osafune/peridot/fpga/peridot_lcdunit/software/lcdunit_ckplay/nd_lib/nd_egl.c.org

/**************************************************************************
	PROCYON コンソールライブラリ「nd_Lib」 (cineraria DE0 Edition)

		プリミティブレベルグラフィックドライバ

	2014/04/28	Cineraria/GREENBERYL両対応修正

 **************************************************************************/

#include "nd_egl.h"

/***** 定数・マクロ定義 ***************************************************/

#define calc_brend(_a,_b,_p)	((((_a)-(_b))*(_p) + ((_b) << 8)) >> 8)

#define nd_FONTX_REPLACE_KANJI			(0x81a0)	// 全角の対応する文字がない場合の置き換え文字(□) 

/***** 構造体定義 *********************************************************/

typedef struct {			/* FONTX形式アスキーフォント */
    char fontid[6];				// "FONTX2"という文字列が入る 
    char name[8];				// フォント名(8文字) 
    nd_u8 width;				// フォントの横幅 
    nd_u8 height;				// フォントの高さ 
    nd_u8 codetype;				// アスキーフォントは0 
} __attribute__ ((packed)) nd_FONTX_ASCII_header;

typedef struct {			/* FONTX形式漢字フォント */
    char fontid[6];				// "FONTX2"という文字列が入る 
    char name[8];				// フォント名(8文字) 
    nd_u8 width;				// フォントの横幅 
    nd_u8 height;				// フォントの高さ 
    nd_u8 codetype;				// 漢字フォントは1 
    nd_u8 tnum;					// 文字コードテーブルのエントリ数 
    struct {
		nd_u16 begin;			// 領域の始まりの文字コード 
		nd_u16 end;				// 領域の終わりの文字コード 
    } codetable[];
} __attribute__ ((packed)) nd_FONTX_KANJI_header;

/**************************************************************************
	VGAコントローラ制御
 **************************************************************************/
volatile nd_u32 nd_GsVgaVsyncCount;
volatile nd_u32 nd_GsVgaVsyncFlag;

void nd_GsVgaVsync_isr(void)
{
	nd_u32 status;

#if defined(VGA_BASE)
	status = IORD(np_VGAIO, 0);
	status &= vga_vsyncirq_clear;
	IOWR(np_VGAIO, 0, status);

#elif defined(LCDC_BASE)
	status = IORD(np_LCDCIO, 0);
	status &= lcdc_vsyncirq_clear;
	IOWR(np_LCDCIO, 0, status);

#endif

	if (nd_GsVgaVsyncCount) nd_GsVgaVsyncCount--;
	nd_GsVgaVsyncFlag = 1;
}

void nd_GsVgaVsync_isrenable(void)
{
	nd_u32 status;

#if defined(VGA_BASE)
	status = IORD(np_VGAIO, 0);
	status &= vga_vsyncirq_clear;
	status |= vga_vsyncirq_enable;
	IOWR(np_VGAIO, 0, status);

#elif defined(LCDC_BASE)
	status = IORD(np_LCDCIO, 0);
	status &= lcdc_vsyncirq_clear;
	status |= lcdc_vsyncirq_enable;
	IOWR(np_LCDCIO, 0, status);
#endif
}

void nd_GsVgaVsync_isrdisable(void)
{
	nd_u32 status;

#if defined(VGA_BASE)
	status = IORD(np_VGAIO, 0);
	status &= ~vga_vsyncirq_enable;
	IOWR(np_VGAIO, 0, status);

#elif defined(LCDC_BASE)
	status = IORD(np_LCDCIO, 0);
	status &= ~lcdc_vsyncirq_enable;
	IOWR(np_LCDCIO, 0, status);

#endif
}

void nd_GsVgaScanOn(void)
{
#if defined(VGA_BASE)
	nd_u32 status;

	status = IORD(np_VGAIO, 0);
	status |= vga_scan_enable;
//	status |= (vga_scan_enable | vga_dither_enable);	// DE0のVGA出力を使う場合 
	IOWR(np_VGAIO, 0, status);

#elif defined(LCDC_BASE)
	IOWR(np_LCDCIO, 1, lcdc_scan_enable);

#endif
}

void nd_GsVgaScanOff(void)
{
#if defined(VGA_BASE)
	nd_u32 status;

	status = IORD(np_VGAIO, 0);
	status &= ~vga_scan_enable;
	IOWR(np_VGAIO, 0, status);

#elif defined(LCDC_BASE)
	IOWR(np_LCDCIO, 1, lcdc_scan_disable);

#endif
}

void nd_GsVgaSetBuffer(nd_u32 base)
{
#if defined(VGA_BASE)
	IOWR(np_VGAIO, 1, base & 0x7fffffffUL);		// アンキャッシュ領域→物理アドレス変換 

#elif defined(LCDC_BASE)
	IOWR(np_LCDCIO, 2, base & 0x7fffffffUL);	// アンキャッシュ領域→物理アドレス変換 

#endif
}

void nd_GsVgaInit(void)
{
	nd_GsVgaVsync_isrdisable();				// 既に起動中だった場合の処理 
	nd_GsVgaScanOff();

	nd_GsVgaVsyncCount = 0;
	nd_GsVgaVsyncFlag  = 0;
}

void nd_GsVgaWaitVsync(void)
{
#if defined(VGA_BASE)
	nd_u32 vsflag;

	vsflag = IORD(np_VGAIO, 0) & vga_vsyncflag_bitmask;
	while(vsflag ==(IORD(np_VGAIO, 0) & vga_vsyncflag_bitmask)) {};

#elif defined(LCDC_BASE)
	nd_u32 status;

	if ( IORD(np_LCDCIO, 0) & lcdc_vsyncirq_enable ) {	// VSYNC割り込みで動作中 
		nd_GsVgaVsyncFlag = 0;
		while( !nd_GsVgaVsyncFlag ) {}

	} else {
		status = IORD(np_LCDCIO, 0);
		status &= lcdc_vsyncirq_clear;
		IOWR(np_LCDCIO, 0, status);
		while( !(IORD(np_LCDCIO, 0) & lcdc_vsync_bitmask) ) {}
	}

#endif
}

nd_u32 nd_GsVgaVsync_getcount(void)
{
#if defined(VGA_BASE)
	if ( IORD(np_VGAIO, 0) & vga_vsyncirq_enable ) {	// VSYNC割り込みで動作中 
		return ( nd_GsVgaVsyncCount );
	} else {
		return ( IORD(np_VGAIO, 2) );
	}

#elif defined(LCDC_BASE)
	if ( IORD(np_LCDCIO, 0) & lcdc_vsyncirq_enable ) {	// VSYNC割り込みで動作中 
		return ( nd_GsVgaVsyncCount );
	} else {
		return ( IORD(np_LCDCIO, 3) );
	}

#endif
}

void nd_GsVgaVsync_setcount(nd_u32 count)
{
#if defined(VGA_BASE)
	if ( IORD(np_VGAIO, 0) & vga_vsyncirq_enable ) {	// VSYNC割り込みで動作中 
		nd_GsVgaVsyncCount = count;
	} else {
		IOWR(np_VGAIO, 2, count);
	}

#elif defined(LCDC_BASE)
	if ( IORD(np_LCDCIO, 0) & lcdc_vsyncirq_enable ) {	// VSYNC割り込みで動作中 
		nd_GsVgaVsyncCount = count;
	} else {
		IOWR(np_LCDCIO, 3, count);
	}

#endif
}

/**************************************************************************
	カレントページをセット
 **************************************************************************/
/*
  形式 
	void nd_GsEglPage(nd_u32 viewpage, nd_u32 drawpage, nd_u32 vs)

  機能
	表示ページと描画ページをセットする
		viewpage : 表示フレームバッファアドレス 
		drawpage : 描画フレームバッファアドレス 
		vs       : 切り替えモード(0:即時切り換え / !0:VSYNCを待って切り替え) 
*/

nd_u32 nd_GsEglDrawBuffer;

void nd_GsEglPage(
		nd_u32 viewpage, nd_u32 drawpage, nd_u32 vs)
{
	if (vs) nd_GsVgaWaitVsync();

	nd_GsVgaSetBuffer(viewpage);
	nd_GsEglDrawBuffer = drawpage;
}

/**************************************************************************
	カラーをセット
 **************************************************************************/
/*
  形式 
	void nd_GsEglColor(nd_u32 color, nd_u32 bg_color, nd_u32 pastel)

  機能
	アクティブカラーを設定する
		color    : 前景色 (0x0000～0xffff)
		bg_color : 背景色 (0x0000～0xffff)
		pastel   : 混合比 (0～256)
*/

static nd_u32 nd_color;
static nd_u32 nd_bgcolor;
static nd_u32 nd_pastel;

void nd_GsEglColor(
		nd_u32 color, nd_u32 bg_color, nd_u32 pastel)
{
	nd_color   = color;
	nd_bgcolor = bg_color;
	nd_pastel  = pastel;
}

/**************************************************************************
	ＶＲＡＭに点を描画
 **************************************************************************/
/*
  形式 
	void nd_GsEglPset(nd_s32 x, nd_s32 y)

  機能
	VRAMの(x,y)にcolorで指定した点を描画する
*/

void nd_GsEglPset(
		nd_s32 x, nd_s32 y)
{
	nd_u16 *p,c;
	nd_s32 r,g,b;

	if( (void *)na_VRAM_base == na_null) return;
	if(nd_pastel == 0) return;

	if((x >= window_xmin)&&(x <= window_xmax) && (y >= window_ymin)&&(y <= window_ymax)) {
		p = (nd_u16 *)( na_VRAM_base + ((draw_base + y)<<na_VRAM_linewidth) + (x<<1));
		c = nd_color;
		if (nd_pastel < 256) {
			r = get_red(*p);
			r = calc_brend(get_red(c),  r, nd_pastel);
			g = get_green(*p);
			g = calc_brend(get_green(c),g, nd_pastel);
			b = get_blue(*p);
			b = calc_brend(get_blue(c), b, nd_pastel);
			c = set_pixel(r,g,b);
		}
		*p = c;
	}
}

/**************************************************************************
	矩形塗りつぶし
 **************************************************************************/
/*
  形式 
	void nd_GsEglBoxfill(nd_s32 x1, nd_s32 y1, nd_s32 x2, nd_s32 y2)

  機能
	VRAMの(x1,y1)-(x2,y2)の矩形内を前景色で指定した色で塗りつぶす
*/

void nd_GsEglBoxfill(
		nd_s32 x1, nd_s32 y1,
		nd_s32 x2, nd_s32 y2)
{
	nd_u16 *p,c;
	nd_s32 r,g,b,x,y;

	if( (void *)na_VRAM_base == na_null) return;
	if(nd_pastel == 0) return;

	if(x1 > x2) { x=x1;  x1=x2;  x2=x; }
	if(y1 > y2) { y=y1;  y1=y2;  y2=y; }

	if(x1 < window_xmin) x1 = window_xmin;
	if(y1 < window_ymin) y1 = window_ymin;
	if(x2 > window_xmax) x2 = window_xmax;
	if(y2 > window_ymax) y2 = window_ymax;

	if(x1 <= x2 && y1 <= y2) {
		for(y=y1 ; y<=y2 ; y++) {
			p = (nd_u16 *)( na_VRAM_base + ((draw_base + y)<<na_VRAM_linewidth) + (x1<<1));
			for(x=x1 ; x<=x2 ; x++) {
				c = nd_color;
				if (nd_pastel < 256) {
					r = get_red(*p);
					r = calc_brend(get_red(c),  r, nd_pastel);
					g = get_green(*p);
					g = calc_brend(get_green(c),g, nd_pastel);
					b = get_blue(*p);
					b = calc_brend(get_blue(c), b, nd_pastel);
					c = set_pixel(r,g,b);
				}
				*p++ = c;
			}
		}
	}
}

void nd_GsEglBox(
		nd_s32 x1, nd_s32 y1,
		nd_s32 x2, nd_s32 y2)
{
	nd_GsEglLine(x1,y1, x2,y1);
	nd_GsEglLine(x1,y2, x2,y2);
	nd_GsEglLine(x2,y1+1, x2,y2-1);
	nd_GsEglLine(x1,y1+1, x1,y2-1);
}

/**************************************************************************
	ミッチェナーアルゴリズムによる高速サークル描画
 **************************************************************************/
/*
  形式 
	void nd_GsEglCircle(nd_s32 x, nd_s32 y, nd_s32 r)

  機能
	VRAMの(x,y)を中心に前景色で指定した色で半径rの円を描画する
*/

void nd_GsEglCircle(
		nd_s32 xc, nd_s32 yc,
		nd_s32 r)
{
	nd_s32 x=0,y,d;

	y = r;
	d = 3 - (r << 1);
	while(x < y) {
		nd_GsEglPset(xc+x,yc+y);
		nd_GsEglPset(xc-x,yc+y);
		nd_GsEglPset(xc+x,yc-y);
		nd_GsEglPset(xc-x,yc-y);
		nd_GsEglPset(xc+y,yc+x);
		nd_GsEglPset(xc-y,yc+x);
		nd_GsEglPset(xc+y,yc-x);
		nd_GsEglPset(xc-y,yc-x);

		if(d < 0) {
			d = d + (x << 2) + 6;
		} else {
			d = d + ((x - y)<< 2) + 10;
			y--;
		}
		x++;
	}
	if(x == y) {
		nd_GsEglPset(xc+x,yc+y);
		nd_GsEglPset(xc-x,yc+y);
		nd_GsEglPset(xc+x,yc-y);
		nd_GsEglPset(xc-x,yc-y);
	}
}

/**************************************************************************
	ブレゼンハムアルゴリズムによる高速ライン描画
 **************************************************************************/
/*
  形式 
	viod nd_GsEglLine(nd_s32 x1, nd_s32 y1, nd_s32 x2, nd_s32 y2)

  機能
	VRAMの(x1,y1)-(x2,y2)に前景色で指定した色でラインを描画する
*/

void nd_GsEglLine(
		nd_s32 x1, nd_s32 y1,
		nd_s32 x2 ,nd_s32 y2)
{
	nd_s32 x,y,dx,dy,c1,c2,d,i;

	if((x2 - x1 + y2 - y1) <= 0) {
		x  = x2;  y  = y2;
		x2 = x1;  y2 = y1;
		x1 = x;   y1 = y;
	}

	nd_GsEglPset(x1,y1);

	dx = x2 - x1;  if(dx < 0) dx = -dx;
	dy = y2 - y1;  if(dy < 0) dy = -dy;

	if(dx > dy) {
		c2 = dy << 1;
		d  = c2 - dx;
		c1 = d - dx;
		if(y1 < y2) i = 1; else i = -1;

		y = y1;
		for(x=x1+1 ; x<=x2 ; x++) {
			if(d > 0) {
				d += c1;
				y += i;
			} else {
				d += c2;
			}
			nd_GsEglPset(x,y);
		}
	} else {
		c2 = dx << 1;
		d  = c2 - dy;
		c1 = d - dy;
		if(x1 < x2) i = 1; else i = -1;

		x = x1;
		for(y=y1+1 ; y<=y2 ; y++) {
			if(d > 0) {
				d += c1;
				x += i;
			} else {
				d += c2;
			}
			nd_GsEglPset(x,y);
		}
	}
}

/**************************************************************************
	FONTX形式フォント描画ライブラリ
 **************************************************************************/

static nd_u8 *pFONTX_kanji_top;		// カレントの漢字フォント 
static nd_u8 *pFONTX_ascii_top;		// カレントのアスキー文字フォント 

// SJIS文字コードからビットマップのオフセットを計算 
// 該当ビットマップが無い場合、na_nullを返す 
static nd_u8 *nd_GsEglFontx_putkanji(nd_s32 kcode,nd_FONTX_KANJI_header *pFont)
{
	nd_s32 i,csize,cb,ce;
	nd_u8 *pKanji;

	csize  = (((nd_s32)pFont->width + 7) >> 3) * (nd_s32)pFont->height;
	pKanji = (nd_u8 *)((nd_u32)pFont + ((nd_s32)pFont->tnum << 2) + 18);

	for(i=0 ; i<pFont->tnum ; i++) {
		cb = pFont->codetable[i].begin;
		ce = pFont->codetable[i].end;
		if (cb <= kcode && kcode <= ce) {
			pKanji += (kcode - cb) * csize;
			i = -1;
			break;

		} else {
			pKanji += (ce - cb + 1) * csize;

		}
	}
	if (i >= 0) pKanji = na_null;

	return pKanji;
}

// ASCII文字コードからビットマップのオフセットを計算 
static nd_u8 *nd_GsEglFontx_ascii(nd_s32 acode,nd_FONTX_ASCII_header *pFont)
{
	nd_s32 csize;
	nd_u8 *pAscii;

	csize  = (((nd_s32)pFont->width + 7) >> 3) * (nd_s32)pFont->height;
	pAscii = (nd_u8 *)((nd_u32)pFont + 17 + (acode * csize));

	return pAscii;
}

// １文字描画 
//  0x0000～0x00ffの範囲はACSII(半角)、0x8000～はKANJI(全角)で描画する 
//  返値として、フォントの横幅を返す 
nd_s32 nd_GsEglPutcharFont(
		nd_s32 x,nd_s32 y,
		nd_u16 c)
{
	nd_FONTX_KANJI_header *pFK;
	nd_FONTX_ASCII_header *pFA;

	nd_s32 i,j,w,h;
	nd_u8 *p,cbit = 0;

	if (c <= 0xff) {		// 半角 
		pFA = (nd_FONTX_ASCII_header *)pFONTX_ascii_top;
		if (pFA == na_null) return 0;

		p = nd_GsEglFontx_ascii(c, pFA);
		w = pFA->width;
		h = pFA->height;

	} else {				// 全角 
		pFK = (nd_FONTX_KANJI_header *)pFONTX_kanji_top;
		if (pFK == na_null) return 0;

		p = nd_GsEglFontx_putkanji(c, pFK);
		if (p == na_null) p = nd_GsEglFontx_putkanji(nd_FONTX_REPLACE_KANJI, pFK);
		w = pFK->width;
		h = pFK->height;

	}

	for(j=0 ; j<h ; j++) {
		for(i=0 ; i<w ; i++,cbit<<=1) {
			if ( !(i & 7) ) cbit = *p++;

			if ( cbit & 0x80 ) {
				nd_GsEglPset(x+i,y+j);
//				nd_GsEglPset(x+i,y+(j<<1));
//				nd_GsEglPset(x+i,y+(j<<1)+1);
			}
		}
	}

	return w;
}

void nd_GsEglPutstrFont(		// 文字列描画 
		nd_s32 x,nd_s32 y,
		char *pStr)
{
	nd_u8 *p = (nd_u8 *)pStr;
	nd_u16 c;

	while(*p != '\0') {
		c = *p++;
		if ((0x81 <= c && c <= 0x9f)||(0xe0 <= c && c <= 0xff)) {
			c = (c << 8) | *p++;
		}

		x += nd_GsEglPutcharFont(x, y, c);
		if (x > window_xmax) break;
	}

}

void nd_GsEglSetFont(			// カレント文字フォントをセット 
		void *pAscii,
		void *pKanji)
{
	pFONTX_ascii_top = (nd_u8 *)pAscii;
	pFONTX_kanji_top = (nd_u8 *)pKanji;
}

/**************************************************************************
	８ドットフォント描画ライブラリ
 **************************************************************************/
/*
  形式 
	void nd_GsEglPutchar(nd_s32 x, nd_s32 y, char *pStr)

  機能
	VRAMの(x,y)から前景色で指定した色とフォントでASCII文字列を描画する。
	８ドットフォントはカレントフォントをに指定しておく
*/
extern const nd_u8 nd_GsEglRomFont[];					// フォント定義 

//static nd_u8 *pFONT8_ascii_top = &nd_GsEglRomFont[0];	// カレントの8ドット文字フォント 
#define pFONT8_ascii_top		nd_GsEglRomFont

void nd_GsEglPutchar(			// １文字描画 
		nd_s32 x,nd_s32 y,
		char s)
{
	nd_s32 i,j,c;

	for(j=0 ; j<8 ; j++) {
		c = *(pFONT8_ascii_top +((s & 0x7f)<< 3)+ j);
		for(i=0 ; i<8 ; i++,c<<=1) {
			if((c & 0x80) != 0) nd_GsEglPset(x+i,y+j);
		}
	}
}

void nd_GsEglPutstr(			// 文字列描画 
		nd_s32 x,nd_s32 y,
		char *pStr)
{
	while(*pStr != '\0') {
		nd_GsEglPutchar(x, y, *pStr);
		x += 8;
		pStr++;
	}

}

void nd_GsEglPutdec(			// 10進数描画 
		nd_s32 x,nd_s32 y,
		nd_s32 c)
{
	char numstr[14];
	nd_s32 i,num,rem;

	if(c < 0) num = -c; else num = c;
	numstr[12] = '0';
	numstr[13] = '\0';

	i = 12;
	while(num > 0) {
		rem = num % 10;
		num /= 10;
		numstr[i--] = (char)(rem | '0');
	}
	if(c < 0) numstr[i] = '-'; else if(i < 12) i++;

	nd_GsEglPutstr(x,y, &numstr[i]);
}

void nd_GsEglPuthex2(			// 8bitバイナリ描画 
		nd_s32 x, nd_s32 y,
		nd_u32 c)
{
	nd_GsEglPutchar(x, y, (char)((c >> 4)&0x0f));
	nd_GsEglPutchar(x+8, y, (char)(c & 0x0f));
}

void nd_GsEglPuthex8(			// 32bitバイナリ描画 
		nd_s32 x,nd_s32 y,
		nd_u32 c)
{
	nd_s32 i;

	for(i=7 ; i>=0 ; i--,c>>=4) {
		nd_GsEglPutchar(x+(i<<3), y, (char)(c & 0x0f));
	}
}

/**************************************************************************
	標準８ドットフォントパターン
 **************************************************************************/

const nd_u8 nd_GsEglRomFont[] = {
	0x1C,0x26,0x63,0x63,0x63,0x32,0x1C,0x00,
	0x0C,0x1C,0x0C,0x0C,0x0C,0x0C,0x3F,0x00,
	0x3E,0x63,0x07,0x1E,0x3C,0x70,0x7F,0x00,
	0x3F,0x06,0x0C,0x1E,0x03,0x63,0x3E,0x00,
	0x0E,0x1E,0x36,0x66,0x7F,0x06,0x06,0x00,
	0x7E,0x60,0x7E,0x03,0x03,0x63,0x3E,0x00,
	0x1E,0x30,0x60,0x7E,0x63,0x63,0x3E,0x00,
	0x7F,0x03,0x06,0x0C,0x18,0x18,0x18,0x00,
	0x3C,0x62,0x72,0x3C,0x4F,0x43,0x3E,0x00,
	0x3E,0x63,0x63,0x3F,0x03,0x06,0x3C,0x00,
	0x1C,0x36,0x63,0x63,0x7F,0x63,0x63,0x00,
	0x7E,0x61,0x61,0x7E,0x61,0x61,0x7E,0x00,
	0x1E,0x33,0x60,0x60,0x60,0x33,0x1E,0x00,
	0x7C,0x66,0x63,0x63,0x63,0x66,0x7C,0x00,
	0x7F,0x60,0x60,0x7E,0x60,0x60,0x7F,0x00,
	0x7F,0x60,0x60,0x7E,0x60,0x60,0x60,0x00,
	0x00,0x00,0x00,0x00,0x00,0x00,0x00,0x00,
	0x00,0x00,0x00,0x00,0x00,0x00,0x00,0x00,
	0x00,0x00,0x00,0x00,0x00,0x00,0x00,0x00,
	0x00,0x00,0x00,0x00,0x00,0x00,0x00,0x00,
	0x00,0x00,0x00,0x00,0x00,0x00,0x00,0x00,
	0x00,0x00,0x00,0x00,0x00,0x00,0x00,0x00,
	0x00,0x00,0x00,0x00,0x00,0x00,0x00,0x00,
	0x00,0x00,0x00,0x00,0x00,0x00,0x00,0x00,
	0x00,0x00,0x00,0x00,0x00,0x00,0x00,0x00,
	0x00,0x00,0x00,0x00,0x00,0x00,0x00,0x00,
	0x00,0x00,0x00,0x00,0x00,0x00,0x00,0x00,
	0x00,0x00,0x00,0x00,0x00,0x00,0x00,0x00,
	0x00,0x00,0x00,0x00,0x00,0x00,0x00,0x00,
	0x00,0x00,0x00,0x00,0x00,0x00,0x00,0x00,
	0x00,0x00,0x00,0x00,0x00,0x00,0x00,0x00,
	0x00,0x00,0x00,0x00,0x00,0x00,0x00,0x00,
	0x00,0x00,0x00,0x00,0x00,0x00,0x00,0x00,
	0x1C,0x1C,0x1C,0x18,0x18,0x00,0x18,0x00,
	0x36,0x36,0x24,0x00,0x00,0x00,0x00,0x00,
	0x13,0x33,0x7E,0x36,0x37,0x7E,0x24,0x00,
	0x3C,0x6E,0x68,0x3E,0x0B,0x6B,0x3E,0x00,
	0x21,0x52,0x24,0x08,0x12,0x25,0x42,0x00,
	0x18,0x24,0x34,0x38,0x4D,0x46,0x39,0x00,
	0x30,0x30,0x10,0x20,0x00,0x00,0x00,0x00,
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
};

/**************************************************************************/
