osafune/peridot/fpga/peridot_lcdunit/software/lcdunit_ckplay/nd_lib/nd_egl.h.org

/**************************************************************************
	PROCYON コンソールライブラリ「nd_Lib」 (cineraria DE0 Edition)

		プリミティブレベルグラフィックドライバ

	2014/04/28	Cineraria/GREENBERYL両対応修正

 **************************************************************************/
#ifndef __nd_egl_lib_
#define __nd_egl_lib_

#include <stdio.h>
#include <alt_types.h>
#include <system.h>
#include <io.h>

//#define PIXELCOLOR_RGB565
//#define PIXELCOLOR_RGB555		// MORGEN,AMETHYST,TURQUOISE,DE0
#define PIXELCOLOR_BGR555		// TOURMALINE,GREENBERYL
//#define PISELCOLOR_YUV422		// モノクロ

/***** 定数・マクロ定義 ***************************************************/

typedef int				nd_s32;				// 符号付き32bit整数 
typedef short			nd_s16;				// 符号付き16bit整数 
typedef char			nd_s8;				// 符号付き8bit整数 
typedef unsigned long	nd_u32;				// 符号無し32bit整数 
typedef unsigned short	nd_u16;				// 符号無し16bit整数 
typedef unsigned char	nd_u8;				// 符号無し8bit整数 

#ifndef na_null
#ifdef NULL
#define na_null		NULL
#else
#define na_null		((void *)0)
#endif
#endif

#define na_VRAM_base		nd_GsEglDrawBuffer
//#define na_VRAM_size		(1024*272*2)
#define na_VRAM_size		(512*96*2)
//#define na_VRAM_linewidth	(11)
#define na_VRAM_linewidth	(10)
#define na_VRAM_linesize	(1<<na_VRAM_linewidth)

#define draw_base			(0)
//#define window_xsize		(480)
#define window_xsize		(400)
#//define window_ysize		(272)
#define window_ysize		(96)
#define window_xmin			(0)
#define window_ymin			(0)
#define window_xmax			(window_xsize-1)
#define window_ymax			(window_ysize-1)

#ifdef PIXELCOLOR_RGB555
#define get_red(_x)			(((_x) & 0x7c00)>> 7)
#define get_green(_x)		(((_x) & 0x03e0)>> 2)
#define get_blue(_x)		(((_x) & 0x001f)<< 3)
#define set_pixel(_r,_g,_b)	( (((_r) & 0xf8)<<7)|(((_g) & 0xf8)<<2)|(((_b) & 0xf8)>>3) )
#endif
#ifdef PIXELCOLOR_BGR555
#define get_red(_x)			(((_x) & 0x001f)<< 3)
#define get_green(_x)		(((_x) & 0x03e0)>> 2)
#define get_blue(_x)		(((_x) & 0x7c00)>> 7)
#define set_pixel(_r,_g,_b)	( (((_r) & 0xf8)>>3)|(((_g) & 0xf8)<<2)|(((_b) & 0xf8)<<7) )
#endif
#ifdef PIXELCOLOR_RGB565
#define get_red(_x)			(((_x) & 0xf100)>> 8)
#define get_green(_x)		(((_x) & 0x07e0)>> 3)
#define get_blue(_x)		(((_x) & 0x001f)<< 3)
#define set_pixel(_r,_g,_b)	( (((_r) & 0xf8)<<8)|(((_g) & 0xfc)<<3)|(((_b) & 0xf8)>>3) )
#endif
#ifdef PISELCOLOR_YUV422
#define get_red(_x)			(0)
#define get_green(_x)		(((_x) & 0xff00)>> 8)
#define get_blue(_x)		(0)
#define set_pixel(_r,_g,_b)	( 0x80 | (((_g) & 0xff)<<8) )
#endif

#define nd_COLORBLACK		set_pixel(  0,  0,  0)
#define nd_COLORBLUE		set_pixel(  0,  0,255)
#define nd_COLORNAVY		set_pixel(  0,  0,128)
#define nd_COLORRED			set_pixel(255,  0,  0)
#define nd_COLORPURPLE		set_pixel(255,  0,255)
#define nd_COLORGREEN		set_pixel(  0,128,  0)
#define nd_COLORLIGHTGREEN	set_pixel(  0,255,  0)
#define nd_COLORSKY			set_pixel(  0,255,255)
#define nd_COLORYELLOW		set_pixel(255,255,  0)
#define nd_COLORWHITE		set_pixel(255,255,255)
#define nd_COLORGRAY		set_pixel(128,128,128)

#define nd_wait_hsync()
#define nd_wait_vsync()					nd_GsVgaWaitVsync()
#define nd_pset(_x,_y)					nd_GsEglPset((_x),(_y))
#define nd_box(_x1,_y1,_x2,_y2)			nd_GsEglBox((_x1),(_y1),(_x2),(_y2))
#define nd_boxfill(_x1,_y1,_x2,_y2)		nd_GsEglBoxfill((_x1),(_y1),(_x2),(_y2))
#define nd_circle(_x,_y,_r)				nd_GsEglCircle((_x),(_y),(_r))
#define nd_line(_x1,_y1,_x2,_y2)		nd_GsEglLine((_x1),(_y1),(_x2),(_y2))
#define nd_symbol(_x1,_y1,_s)			nd_GsEglPutstrFont((_x1),(_y1),(_s))
#define nd_color(_cc,_cb,_p)			nd_GsEglColor((_cc),(_cb),(_p))

/***** 構造体定義 *********************************************************/

#ifdef VGA_BASE
 #define np_VGAIO				(VGA_BASE)
 #define vga_vsyncirq_enable	(1<<15)
 #define vga_vsyncirq_disable	(0<<15)
 #define vga_vsync_bitmask		(1<<14)
 #define vga_vsyncirq_clear		(~(1<<14))
 #define vga_vsyncflag_bitmask	(1<<13)
 #define vga_ovrerr_bitmask		(1<<12)
 #define vga_dither_enable		(1<<1)
 #define vga_dither_disable		(0<<1)
 #define vga_scan_enable		(1<<0)
 #define vga_scan_disable		(0<<0)
#endif

#ifdef LCDC_BASE
 #define np_LCDCIO				(LCDC_BASE)
 #define lcdc_vsyncirq_enable	(1<<15)
 #define lcdc_vsyncirq_disable	(0<<15)
 #define lcdc_hsyncirq_enable	(1<<14)
 #define lcdc_hsyncirq_disable	(0<<14)
 #define lcdc_vsync_bitmask		(1<<13)
 #define lcdc_hsync_bitmask		(1<<12)
 #define lcdc_vsyncirq_clear	(~(1<<13))
 #define lcdc_hsyncirq_clear	(~(1<<12))
 #define lcdc_lineirq_bitmask	(0x003f)
 #define lcdc_vdouble_enable	(1<<2)
 #define lcdc_hdouble_enable	(1<<1)
 #define lcdc_scan_enable		(1<<0)
 #define lcdc_scan_disable		(0<<0)
#endif

/***** プロトタイプ宣言 ***************************************************/

extern nd_u32 nd_GsEglDrawBuffer;

extern void nd_GsVgaVsync_isr(void);
extern void nd_GsVgaVsync_isrenable(void);
extern void nd_GsVgaVsync_isrdisable(void);
extern void nd_GsVgaScanOn(void);
extern void nd_GsVgaScanOff(void);
extern void nd_GsVgaSetBuffer(nd_u32);
extern void nd_GsVgaInit(void);
extern void nd_GsVgaWaitVsync(void);
extern nd_u32 nd_GsVgaVsync_getcount(void);
extern void nd_GsVgaVsync_setcount(nd_u32);

extern void nd_GsEglPage(nd_u32,nd_u32,nd_u32);
extern void nd_GsEglColor(nd_u32,nd_u32,nd_u32);
extern void nd_GsEglPset(nd_s32,nd_s32);
extern void nd_GsEglBoxfill(nd_s32,nd_s32,nd_s32,nd_s32);
extern void nd_GsEglBox(nd_s32,nd_s32,nd_s32,nd_s32);
extern void nd_GsEglCircle(nd_s32,nd_s32,nd_s32);
extern void nd_GsEglLine(nd_s32,nd_s32,nd_s32,nd_s32);
extern nd_s32 nd_GsEglPutcharFont(nd_s32,nd_s32,nd_u16);
extern void nd_GsEglPutstrFont(nd_s32,nd_s32,char *);
extern void nd_GsEglSetFont(void *,void *);
extern void nd_GsEglPutchar(nd_s32,nd_s32,char);
extern void nd_GsEglPutstr(nd_s32,nd_s32,char *);
extern void nd_GsEglPutdec(nd_s32,nd_s32,nd_s32);
extern void nd_GsEglPuthex2(nd_s32,nd_s32,nd_u32);
extern void nd_GsEglPuthex8(nd_s32,nd_s32,nd_u32);

#endif
/**************************************************************************/
