osafune/peridot/pcb/v1.1/peridot_pcb_meralmask_v1.1.pdf

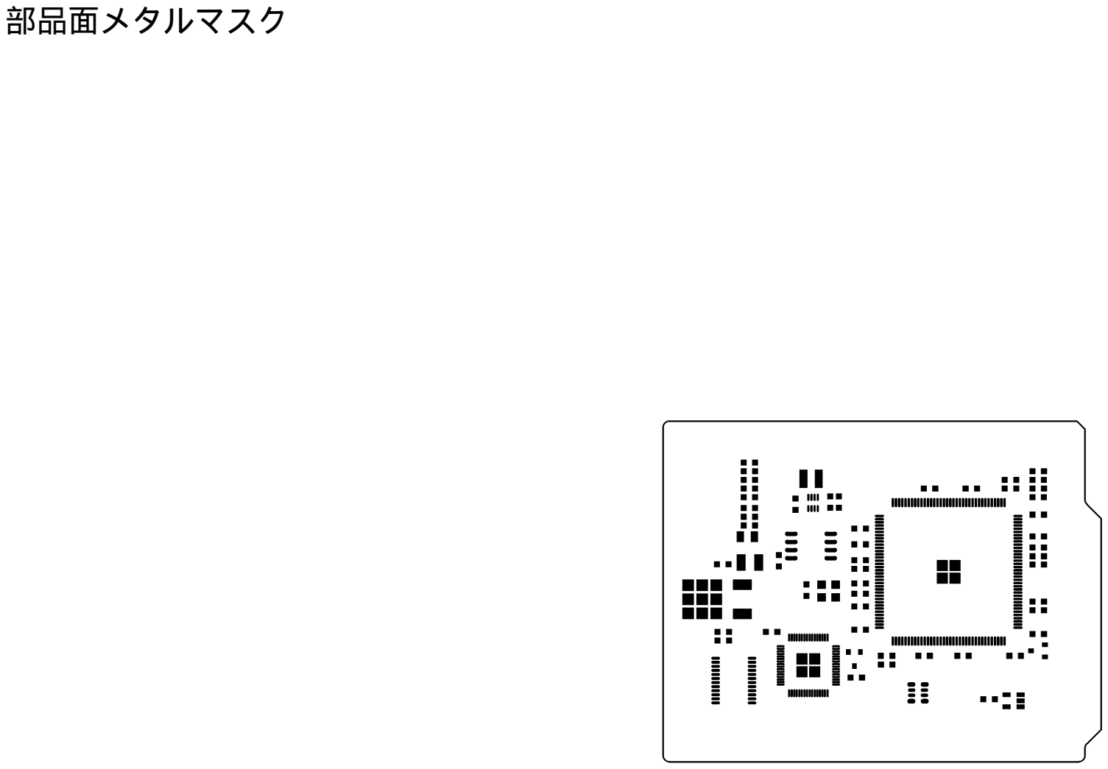
[picture p1: page 1]
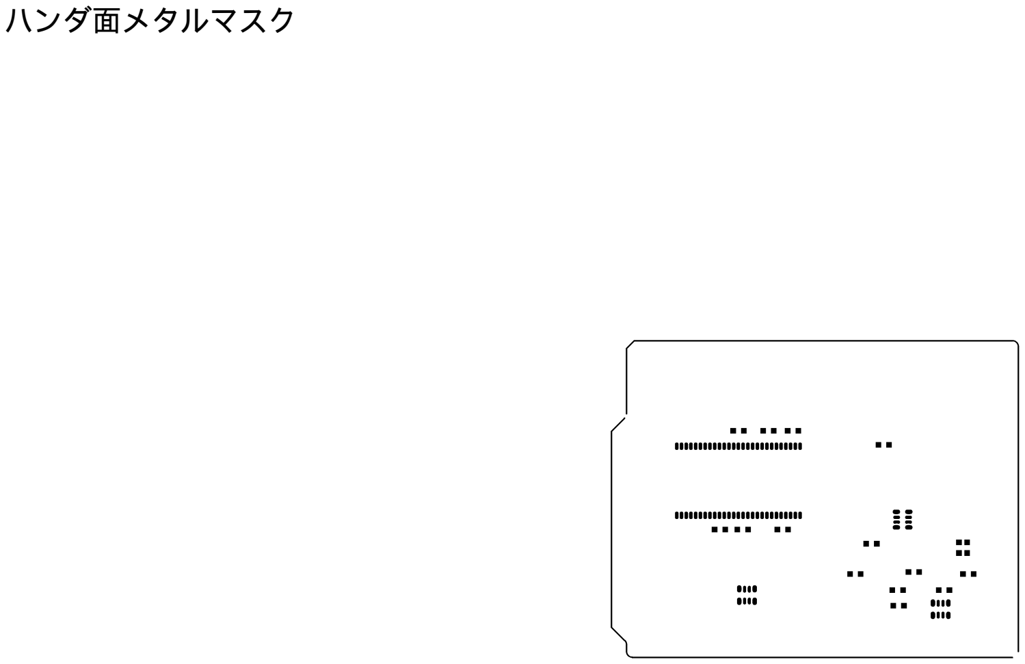
[picture p2: page 2]
