osafune/peridot/pcb/v1.0/peridot_pcb_ver1.0.pdf

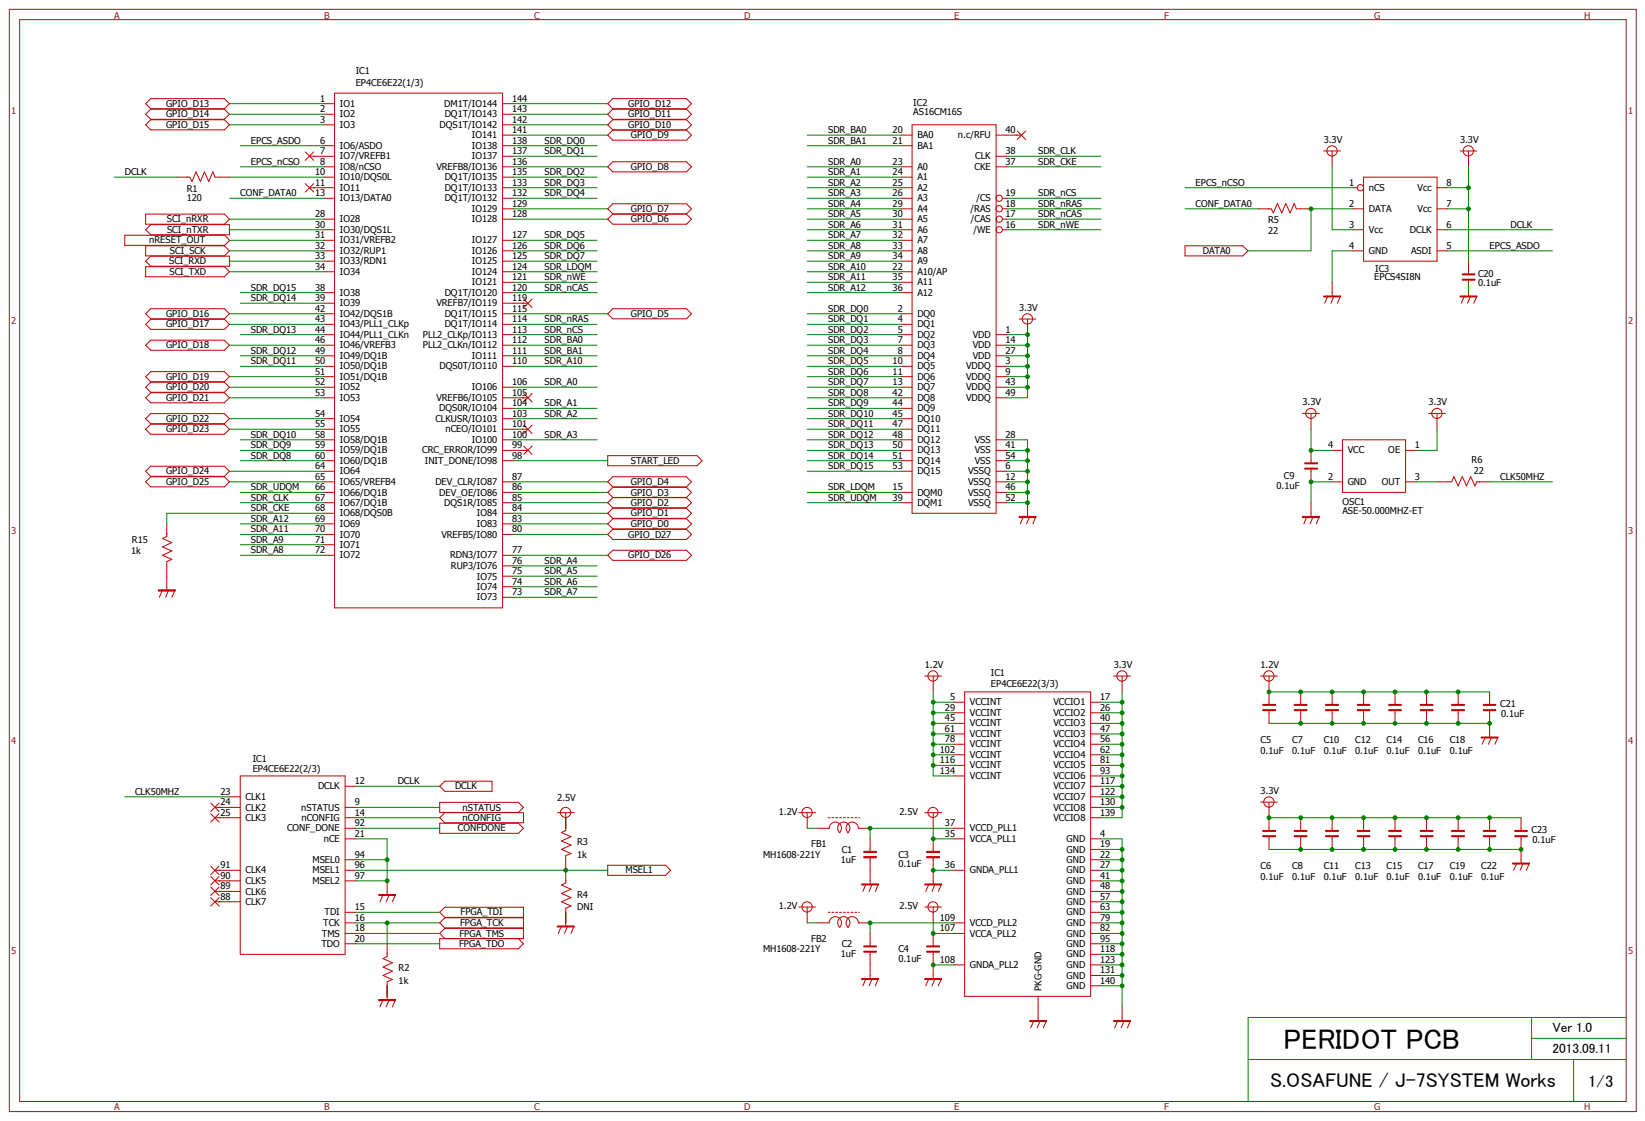
[picture p3: page 1]
YFB; PKG-GND

2 9 | 2 6
4 5 | 4 0
6 1 | 4 7 | 5 C 7 C 1 0 C 1 2 C 1 4 C 1 6 C 1 8 . 1 u F 0 . 1 u F 0 . 1 u F 0 . 1 u F 0 . 1 u F 0 . 1 u F 0 . 1 u F . 3 V
7 8 | 5 6
1 0 2 | 6 2
1 1 6 | 8 1
1 3 4 | 9 3

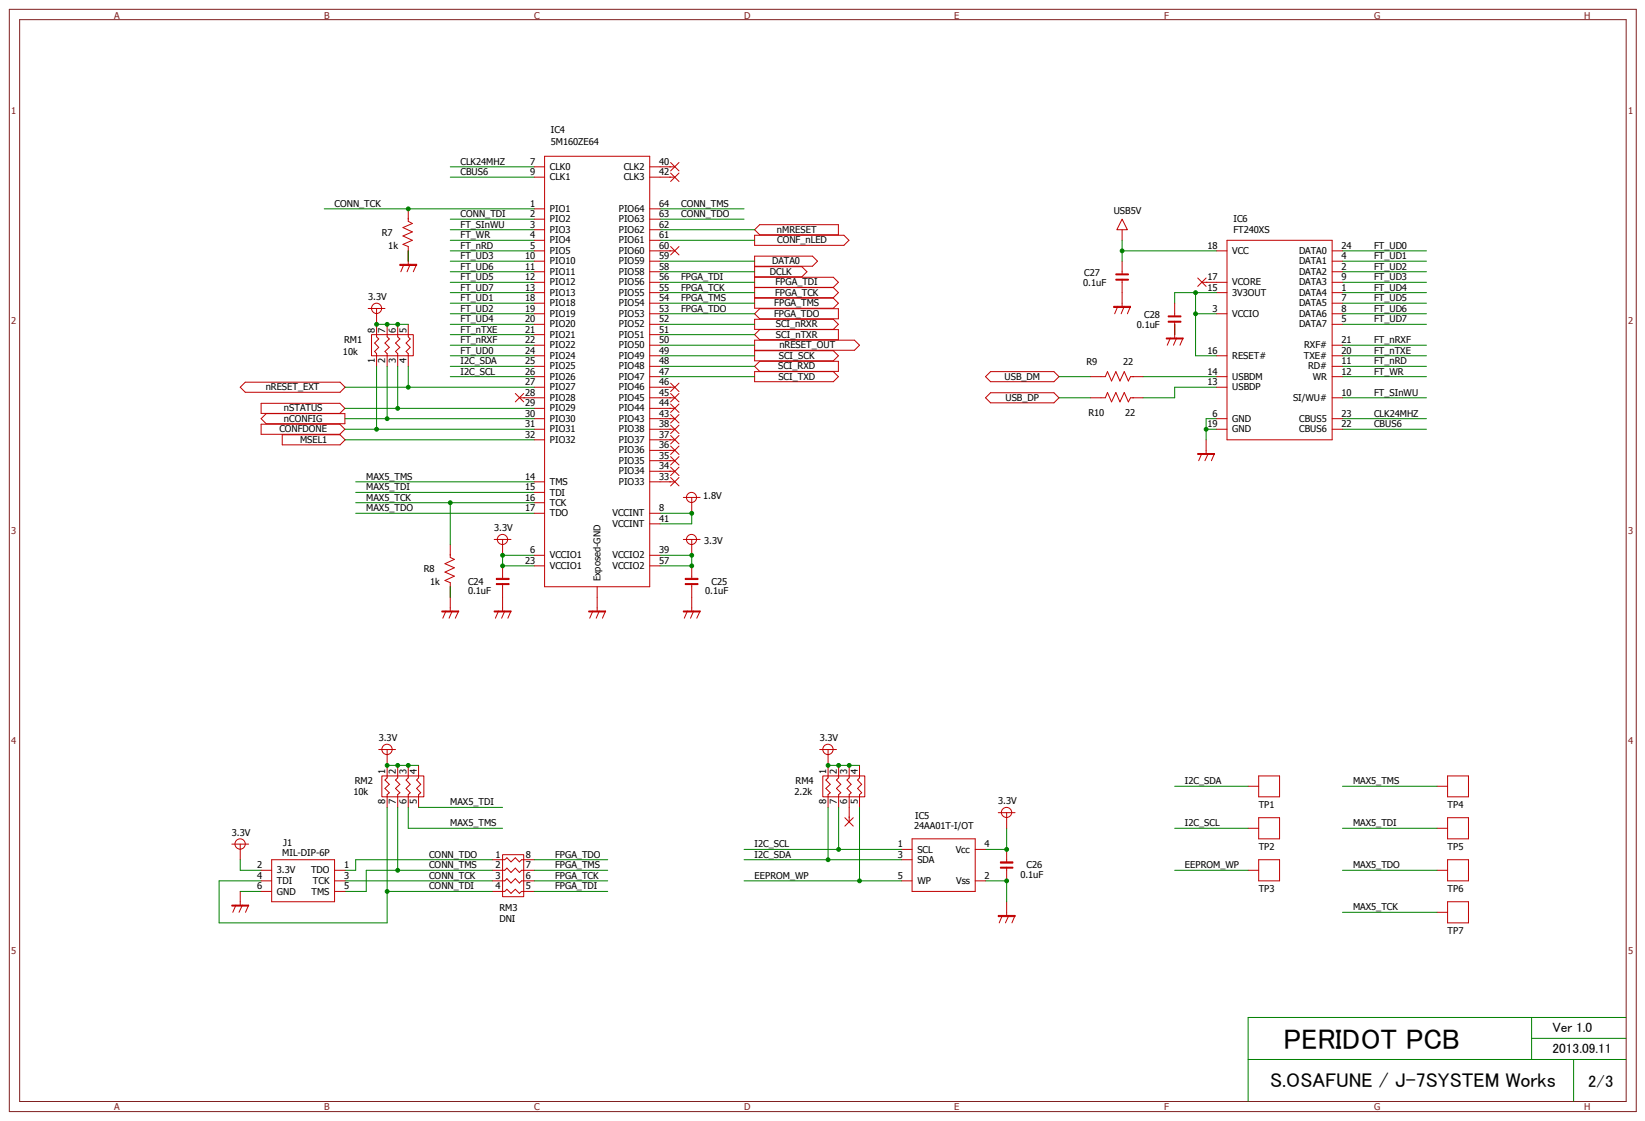
[picture p4: page 2]

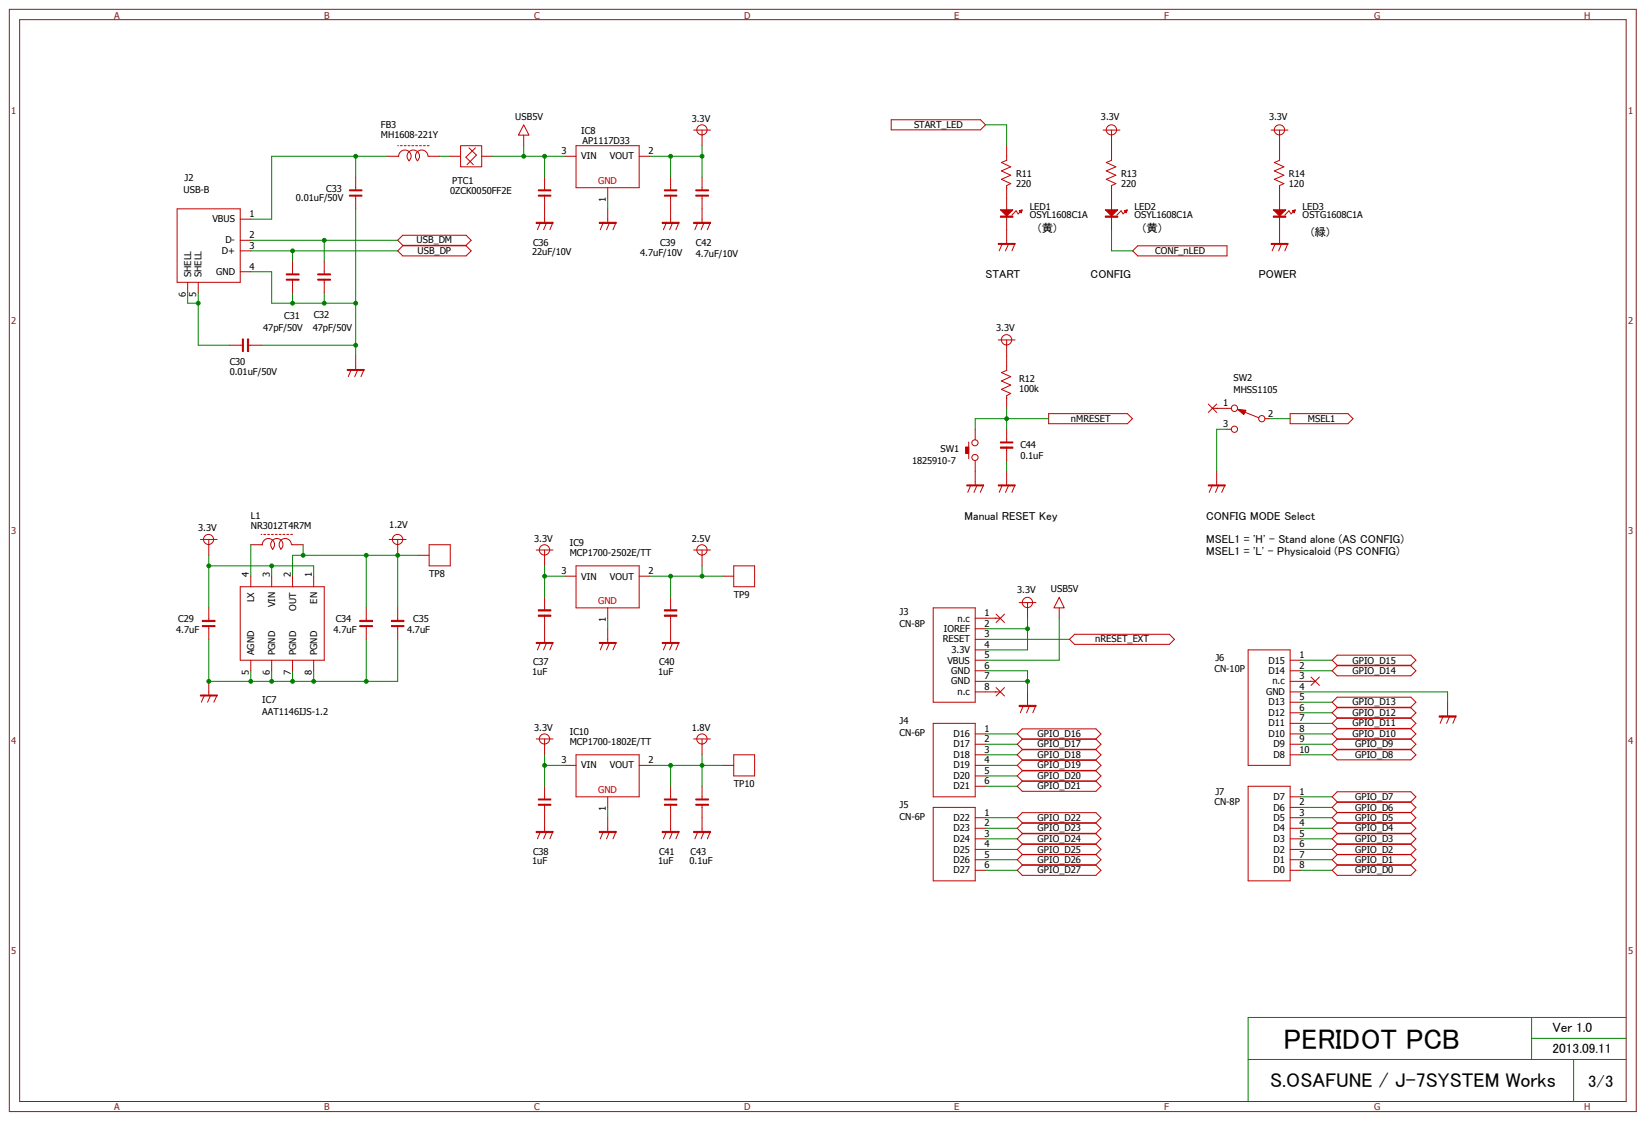
[picture p5: page 3]

MSEL1 = 'H' - Stand alone (AS CONFIG)
MSEL1 = 'L' - Physicaloid (PS CONFIG)

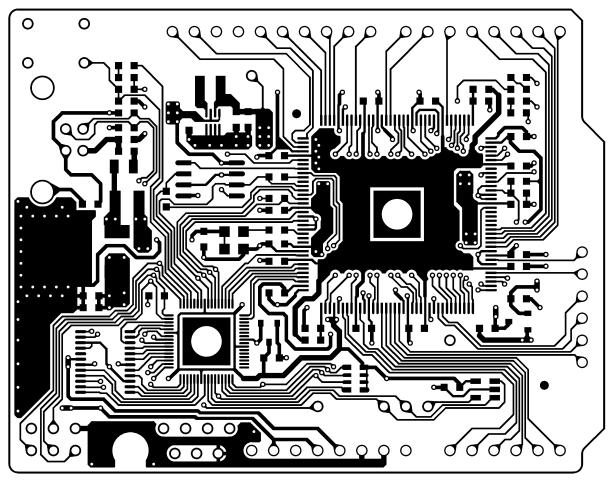
[picture p6: page 4]
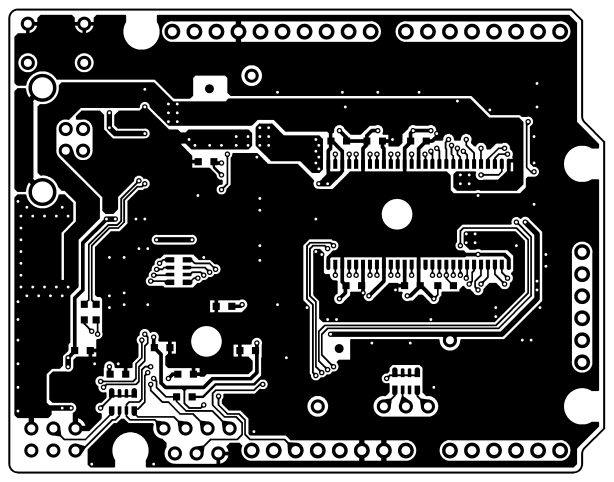
[picture p7: page 5]
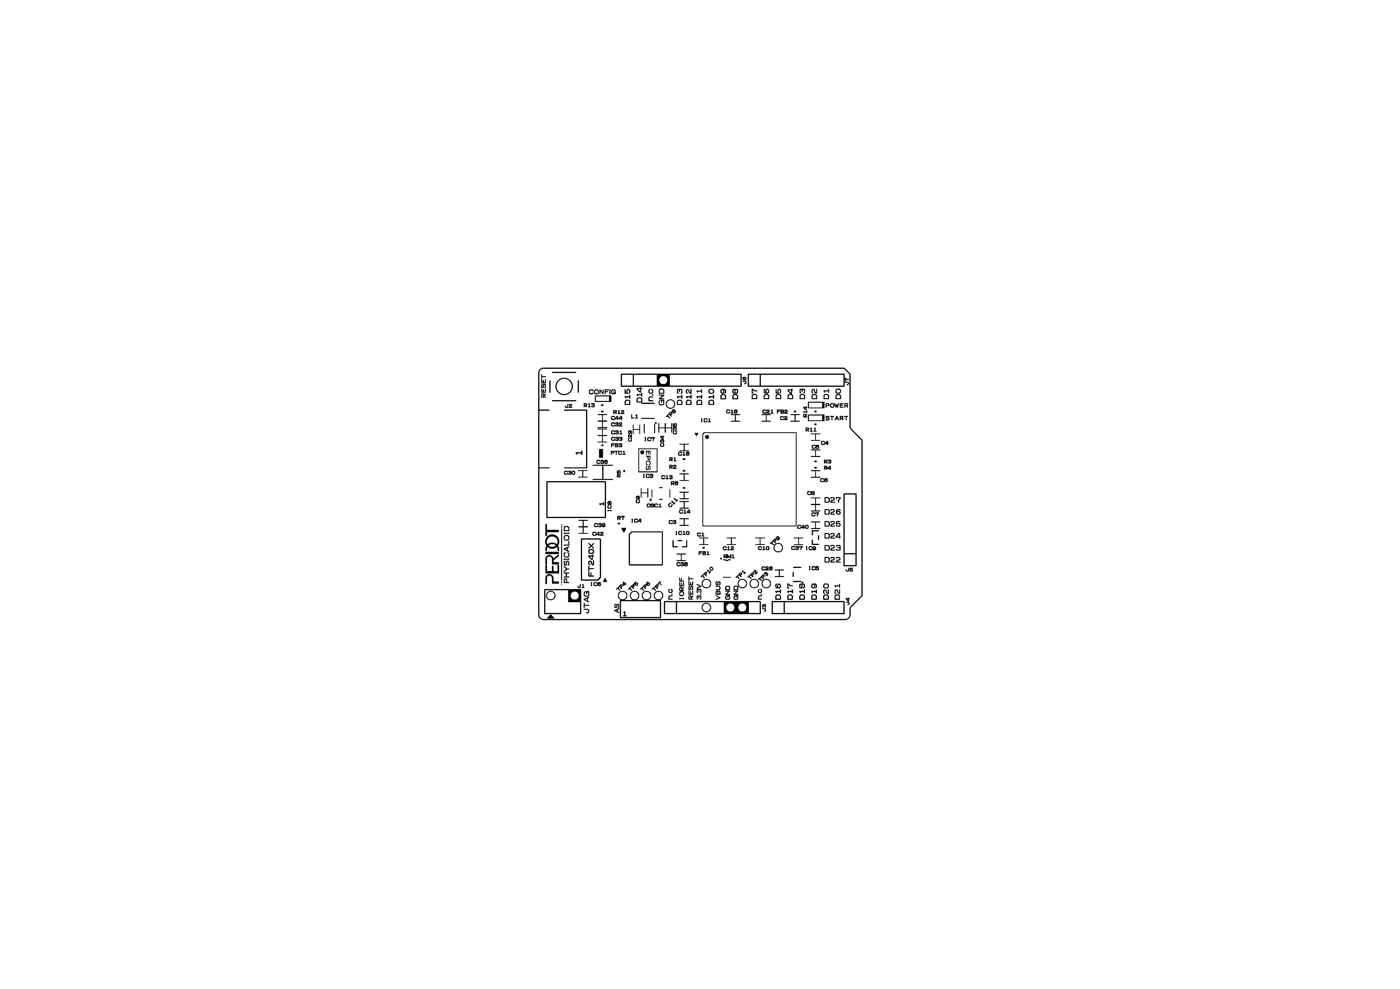
[picture p8: page 6]
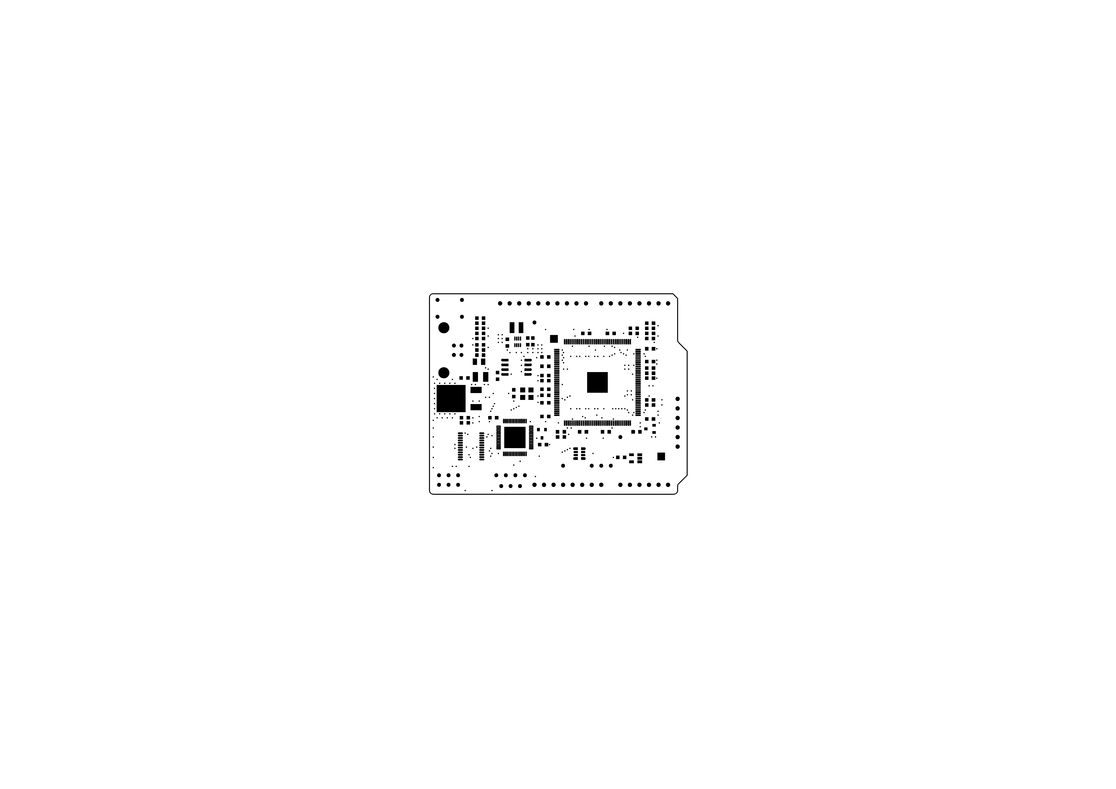
[picture p9: page 7]
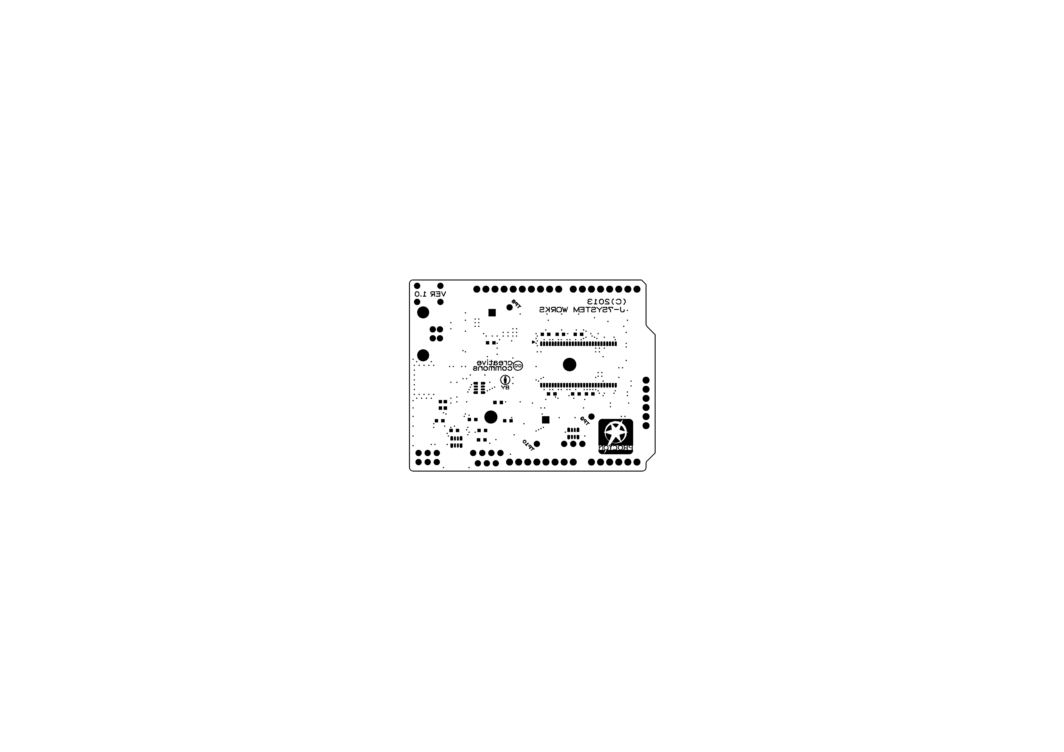
[picture p10: page 8]
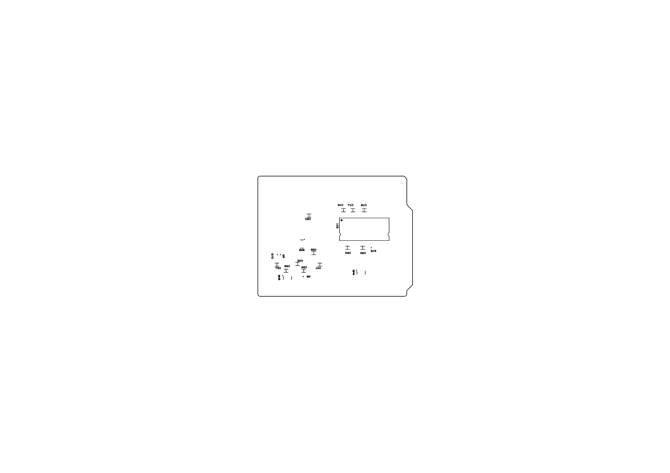
[picture p11: page 9]
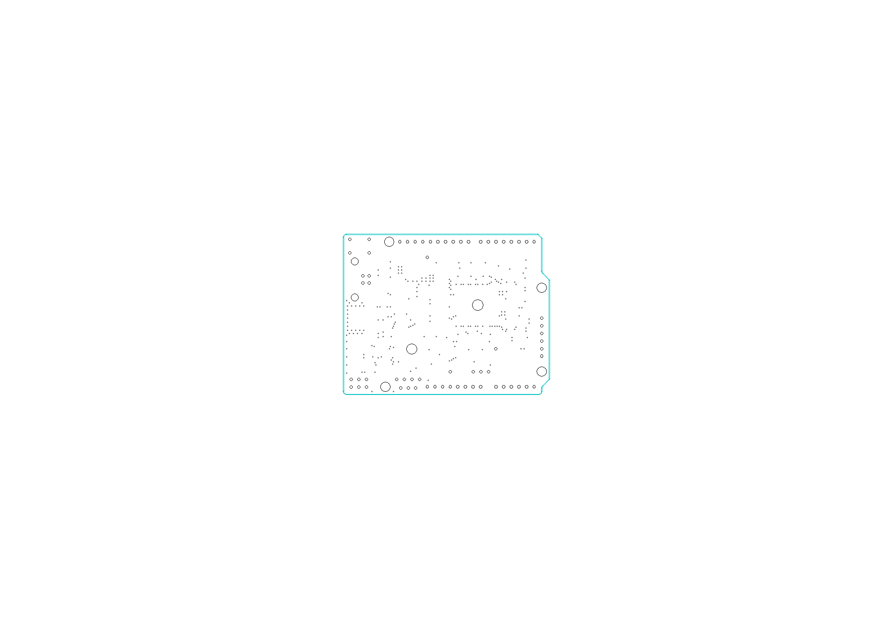
[picture p12: page 10]
