osafune/peridot/pcb/PERIDOT_PINOUT.png

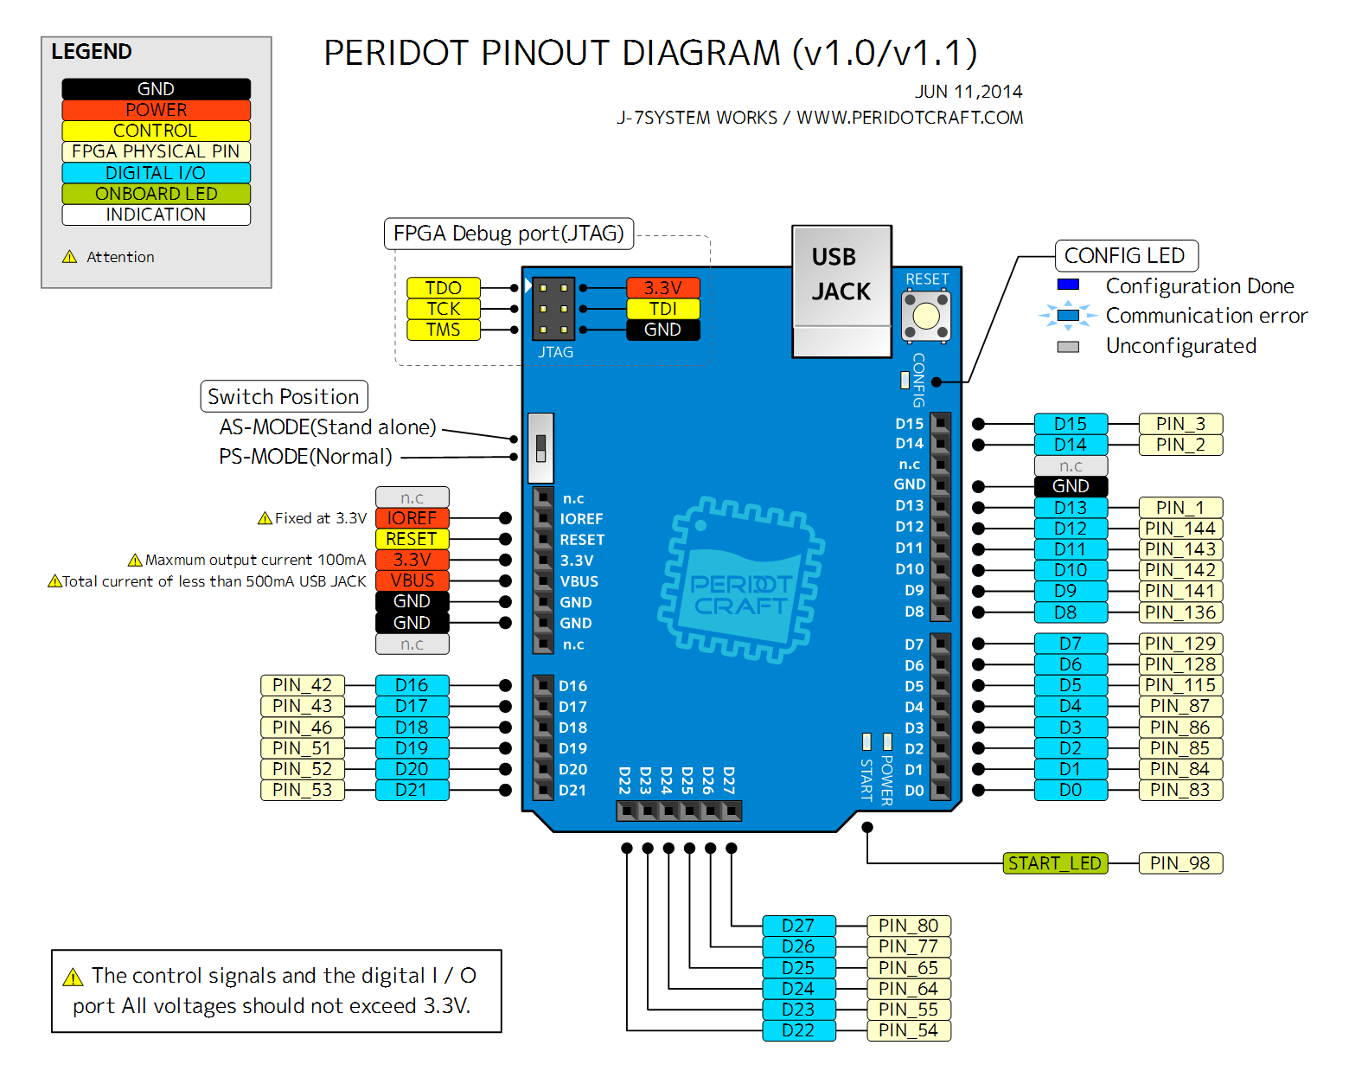
pcb/PERIDOT_PINOUT.png
