osafune/peridot/(list of files, drawings)

Other design files:
pcb/v1.0/schema/peridot_pcb_release.pcb
pcb/v1.1/schema/peridot_pcb_v1.1.pcb
