osafune/peridot/fpga/peridot_lcdunit/software/lcdunit_ckplay/mmcfs/mmcfs.h

/**************************************************************************
	MMC/SDカードSPIアクセスペリフェラル
		ファイルサブシステム・デバイスドライバ関数 (NiosII HAL version)

		UPDATE 2011/02/19
		UPDATE 2014/04/28
 **************************************************************************/
#ifndef __mmcfs_h_
#define __mmcfs_h_


/***** 定数・マクロ定義 ***************************************************/

//#define MMCFS_FD_MAXNUM		(16)
#define MMCFS_FD_MAXNUM		(2)


/***** 構造体定義 *********************************************************/



/***** プロトタイプ宣言 ***************************************************/

/* デバイス登録とファイルシステム初期化 */
int mmcfs_setup(void);



#endif
/**************************************************************************/
