osafune/peridot/(commit log)

2013-11-05 ファーストリリース
2013-11-05 readme.md修正
2013-11-07 サンプル追加
2014-06-20 readme修正
2014-06-20 サンプル更新
2014-06-24 サンプル修正
2014-08-02 CPLD v1.1追加
2014-08-07 Canarium.js v0.9.2アップデート
2014-08-10 PCB v1.1wo
    [peridot_pcb_release.pcb, peridot_pcb_v1.1.pcb]
2014-08-10 Canarium.js v0.9.3アップデート
2014-08-11 Canarium.js v0.9.4 & FPGAサンプル追加
2014-08-19 Canarium.js v0.9.5アップデート
2014-08-24 RBF-WRITER v0.2アップデート＆README更新
2014-08-26 README更新
2014-10-10 pdf追加
2016-08-04 peridotmoniterアップデート
    Canarium.js 0.9.8
2016-08-04 peridotmoniter リリース
